DBXYD/Robotic_HolonomeRobot/hardware_3D/supportRobot.stl

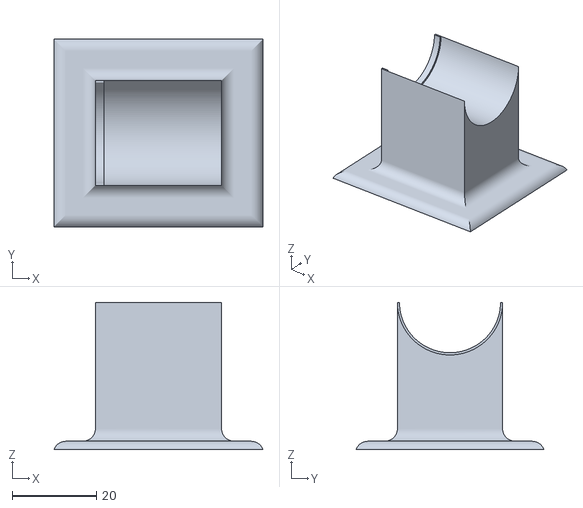
[picture p1: CAD file, 2023-02-05]
hardware_3D/supportRobot.stl
49.7 x 44.7 x 35.0
