DBXYD/Robotic_HolonomeRobot/hardware_PCB/holonomeRobot_alpha.kicad_pcb

## KiCad design hardware_PCB/holonomeRobot_alpha.kicad_pcb (2023-02-05)

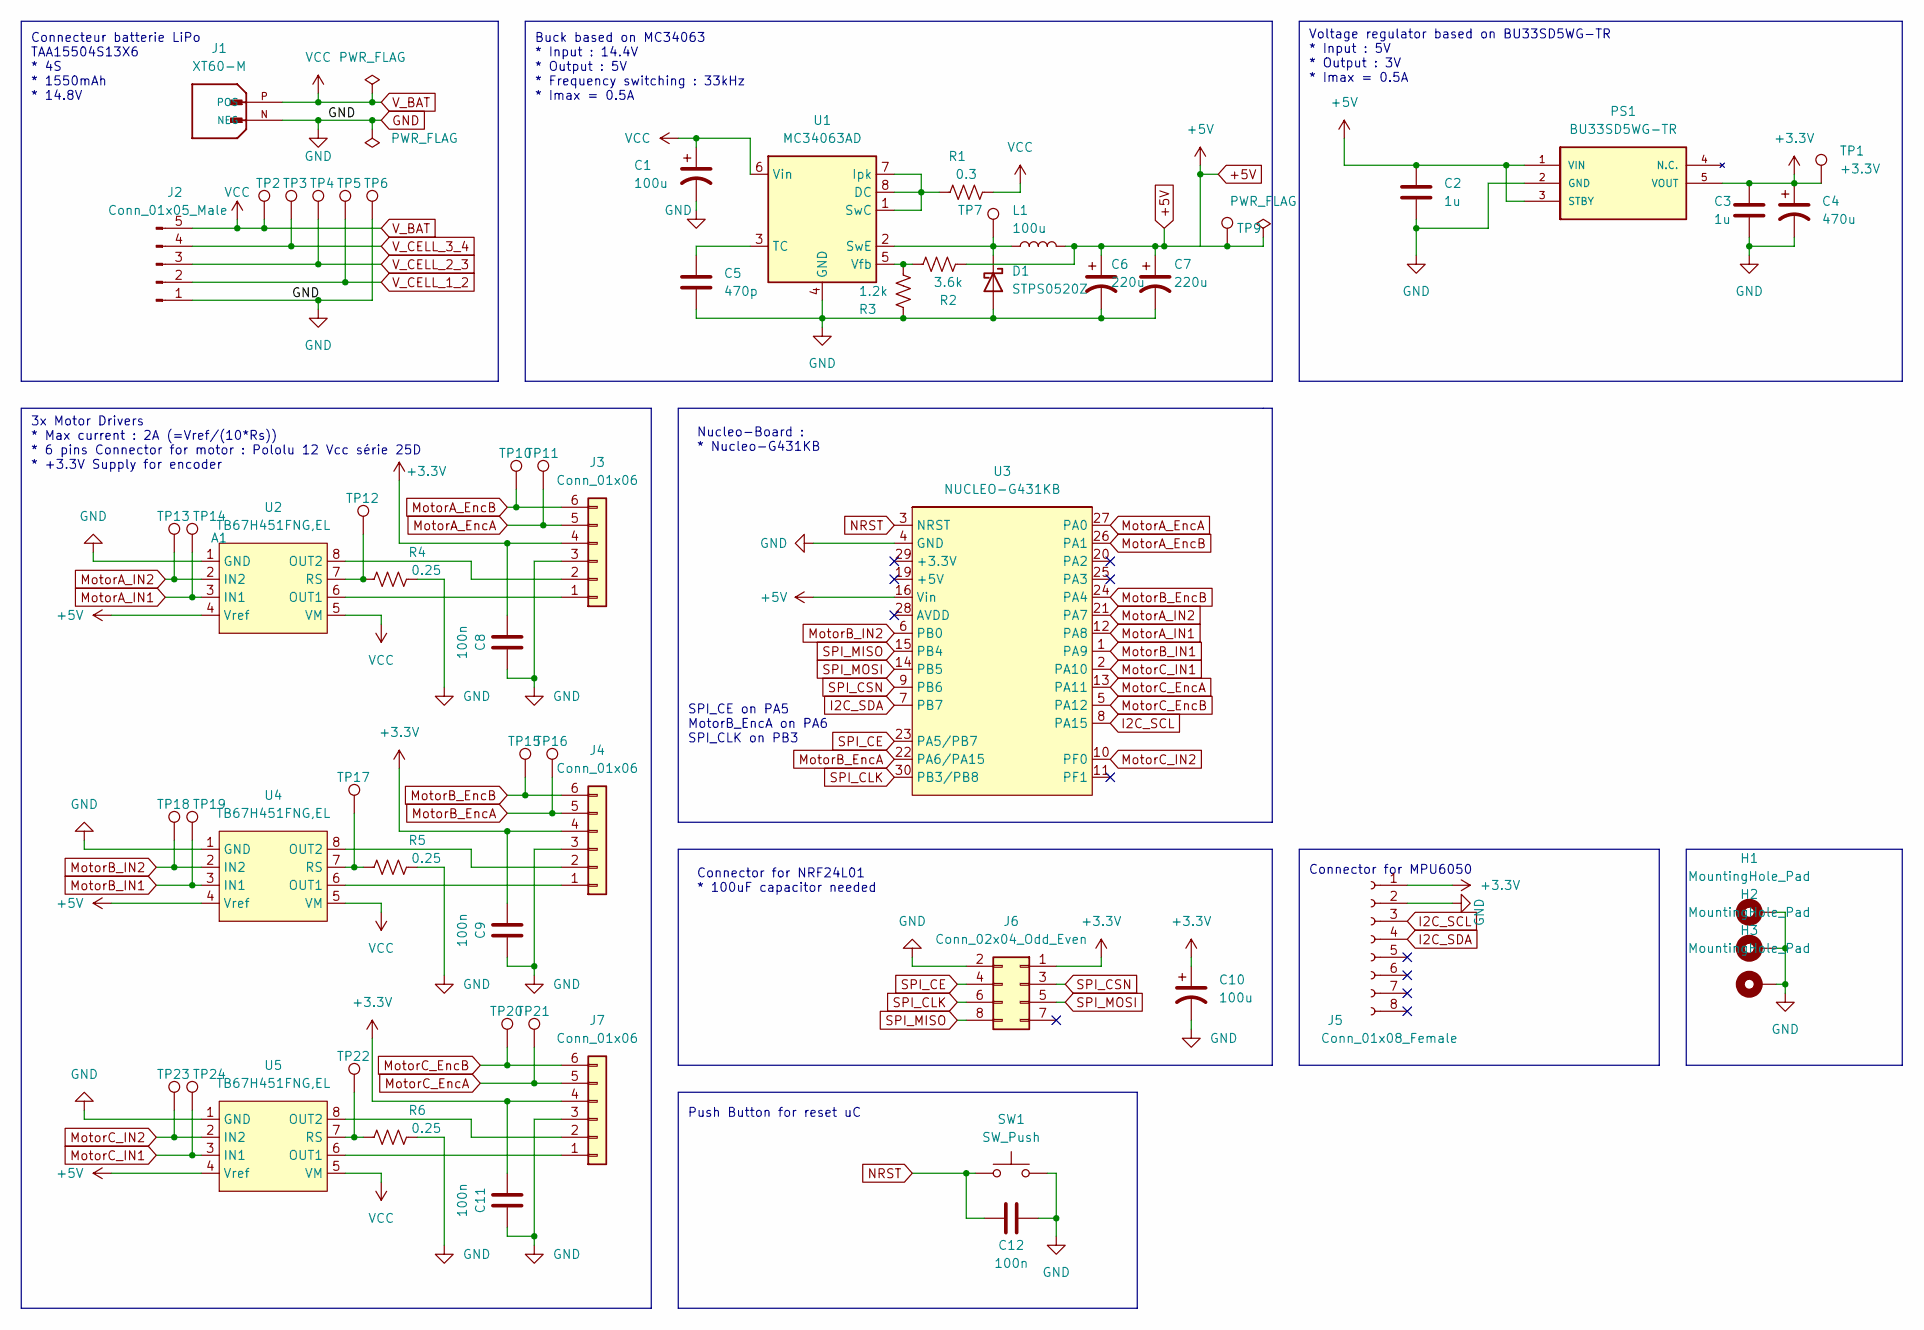
[picture p2: schematic holonomeRobot_alpha.kicad_sch, Holonome Robot]

Parts:
C1, C10: 100u; CP_Elec_6.3x7.7
C2, C3: 1u; C_0603_1608Metric_Pad1.08x0.95mm_HandSolder
C4: 470u; CP_Elec_10x10.5
C5: 470p; C_0603_1608Metric_Pad1.08x0.95mm_HandSolder
C6, C7: 220u; CP_Elec_8x10.5
C8, C9, C11, C12: 100n; C_0603_1608Metric_Pad1.08x0.95mm_HandSolder
D1: STPS0520Z; D_SOD-123
H1, H2, H3: MountingHole_Pad; MountingHole_3.2mm_M3_Pad
J1: XT60-M; AMASS_XT60-M; PARTREV V1.2
J2: Conn_01x05_Male; JST_XH_B5B-XH-A_1x05_P2.50mm_Vertical
J3, J4, J7: Conn_01x06; JST_XH_S6B-XH-A_1x06_P2.50mm_Horizontal
J5: Conn_01x08_Female; PinSocket_1x08_P2.54mm_Vertical
J6: Conn_02x04_Odd_Even; PinSocket_2x04_P2.54mm_Vertical
L1: 100u; L_12x12mm_H6mm
PS1: BU33SD5WG-TR; SOT95P280X125-5N; Manufacturer_Part_Number BU33SD5WG-TR; Mouser_Part_Number 755-BU33SD5WG-TR
R1: 0.3; R_0603_1608Metric_Pad0.98x0.95mm_HandSolder
R2: 3.6k; R_0603_1608Metric_Pad0.98x0.95mm_HandSolder
R3: 1.2k; R_0603_1608Metric_Pad0.98x0.95mm_HandSolder
R4, R5, R6: 0.25; R_0603_1608Metric_Pad0.98x0.95mm_HandSolder
SW1: SW_Push; SW_SMD_2-1437565-8_4_4.50_6.00_6.00_5.00
TP1: +3.3V; TestPoint_Pad_D1.0mm
TP2: V_BAT; TestPoint_Pad_D1.0mm
TP3: V_CELL_3_4; TestPoint_Pad_D1.0mm
TP4: V_CELL_2_3; TestPoint_Pad_D1.0mm
TP5: V_CELL_1_2; TestPoint_Pad_D1.0mm
TP6: GND_BAT; TestPoint_Pad_D1.0mm
TP7: BUCK_OUT; TestPoint_Pad_D1.0mm
TP9: +5V; TestPoint_Pad_D1.0mm
TP10: AEncB; TestPoint_Pad_D1.0mm
TP11: AEncA; TestPoint_Pad_D1.0mm
TP12: RsA; TestPoint_Pad_D1.0mm
TP13: A2; TestPoint_Pad_D1.0mm
TP14: A1; TestPoint_Pad_D1.0mm
TP15: BEncB; TestPoint_Pad_D1.0mm
TP16: BEncA; TestPoint_Pad_D1.0mm
TP17: RsB; TestPoint_Pad_D1.0mm
TP18: B2; TestPoint_Pad_D1.0mm
TP19: B1; TestPoint_Pad_D1.0mm
TP20: CEncB; TestPoint_Pad_D1.0mm
TP21: CEncA; TestPoint_Pad_D1.0mm
TP22: RsC; TestPoint_Pad_D1.0mm
TP23: C2; TestPoint_Pad_D1.0mm
TP24: C1; TestPoint_Pad_D1.0mm
U1: MC34063AD; SOIC-8_3.9x4.9mm_P1.27mm
U2, U4, U5: TB67H451FNG,EL; HSOP-8-1EP_3.9x4.9mm_P1.27mm_EP2.41x3.1mm
U3: NUCLEO-G431KB; MODULE_NUCLEO-G431KB

Connections:
+3.3V: C3.1, C4.1, C8.2, C9.2, C10.1, C11.2, J3.4, J4.4, J5.1, J6.1, J7.4, PS1.5 (VOUT), TP1.1
+5V: C2.1, C6.1, C7.1, L1.2, PS1.1 (VIN), PS1.3 (STBY), R2.2, TP9.1, U2.4 (Vref), U3.16 (Vin), U4.4 (Vref), U5.4 (Vref)
GND: C1.2, C2.2, C3.2, C4.2, C5.2, C6.2, C7.2, C8.1, C9.1, C10.2, C11.1, C12.1, D1.2 (A), H1.1, H2.1, H3.1, J1.N (NEG), J2.1, J3.3, J4.3, J5.2, J6.2, J7.3, PS1.2 (GND), R3.2, R4.2, R5.2, R6.2, SW1.2, TP6.1, U1.4 (GND), U2.1 (GND), U3.4 (GND), U4.1 (GND), U5.1 (GND)
I2C_SCL: J5.3, U3.8 (PA15)
I2C_SDA: J5.4, U3.7 (PB7)
MotorA_EncA: J3.5, TP11.1, U3.27 (PA0)
MotorA_EncB: J3.6, TP10.1, U3.26 (PA1)
MotorA_IN1: TP14.1, U2.3 (IN1), U3.12 (PA8)
MotorA_IN2: TP13.1, U2.2 (IN2), U3.21 (PA7)
MotorB_EncA: J4.5, TP16.1, U3.22 (PA6/PA15)
MotorB_EncB: J4.6, TP15.1, U3.24 (PA4)
MotorB_IN1: TP19.1, U3.1 (PA9), U4.3 (IN1)
MotorB_IN2: TP18.1, U3.6 (PB0), U4.2 (IN2)
MotorC_EncA: J7.5, TP21.1, U3.13 (PA11)
MotorC_EncB: J7.6, TP20.1, U3.5 (PA12)
MotorC_IN1: TP24.1, U3.2 (PA10), U5.3 (IN1)
MotorC_IN2: TP23.1, U3.10 (PF0), U5.2 (IN2)
NRST: C12.2, SW1.1, U3.3 (NRST)
unnamed: C5.1, U1.3 (TC)
unnamed: D1.1 (K), L1.1, TP7.1, U1.2 (SwE)
unnamed: J3.1, U2.6 (OUT1)
unnamed: J3.2, U2.8 (OUT2)
unnamed: J7.1, U5.6 (OUT1)
unnamed: J7.2, U5.8 (OUT2)
unnamed: R1.1, U1.1 (SwC), U1.7 (Ipk), U1.8 (DC)
unnamed: R2.1, R3.1, U1.5 (Vfb)
unnamed: R4.1, TP12.1, U2.7 (RS)
unnamed: R5.1, TP17.1, U4.7 (RS)
unnamed: R6.1, TP22.1, U5.7 (RS)
unnamed: J4.1, U4.6 (OUT1)
unnamed: J4.2, U4.8 (OUT2)
SPI_CE: J6.4, U3.23 (PA5/PB7)
SPI_CLK: J6.6, U3.30 (PB3/PB8)
SPI_CSN: J6.3, U3.9 (PB6)
SPI_MISO: J6.8, U3.15 (PB4)
SPI_MOSI: J6.5, U3.14 (PB5)
V_BAT: C1.1, J1.P (POS), J2.5, R1.2, TP2.1, U1.6 (Vin), U2.5 (VM), U4.5 (VM), U5.5 (VM)
V_CELL_1_2: J2.2, TP5.1
V_CELL_2_3: J2.3, TP4.1
V_CELL_3_4: J2.4, TP3.1

Notes on the sheet:
3x Motor Drivers * Max current : 2A (=Vref/(10*Rs)) * 6 pins Connector for motor : Pololu 12 Vcc série 25D * +3.3V Supply for encoder
SPI_CE on PA5 MotorB_EncA on PA6 SPI_CLK on PB3
Voltage regulator based on BU33SD5WG-TR * Input : 5V * Output : 3V * Imax = 0.5A
Connector for MPU6050
Connector for NRF24L01 * 100uF capacitor needed
Push Button for reset uC
Connecteur batterie LiPo TAA15504S13X6 * 4S * 1550mAh * 14.8V
Nucleo-Board : * Nucleo-G431KB
Buck based on MC34063 * Input : 14.4V * Output : 5V * Frequency switching : 33kHz * Imax = 0.5A

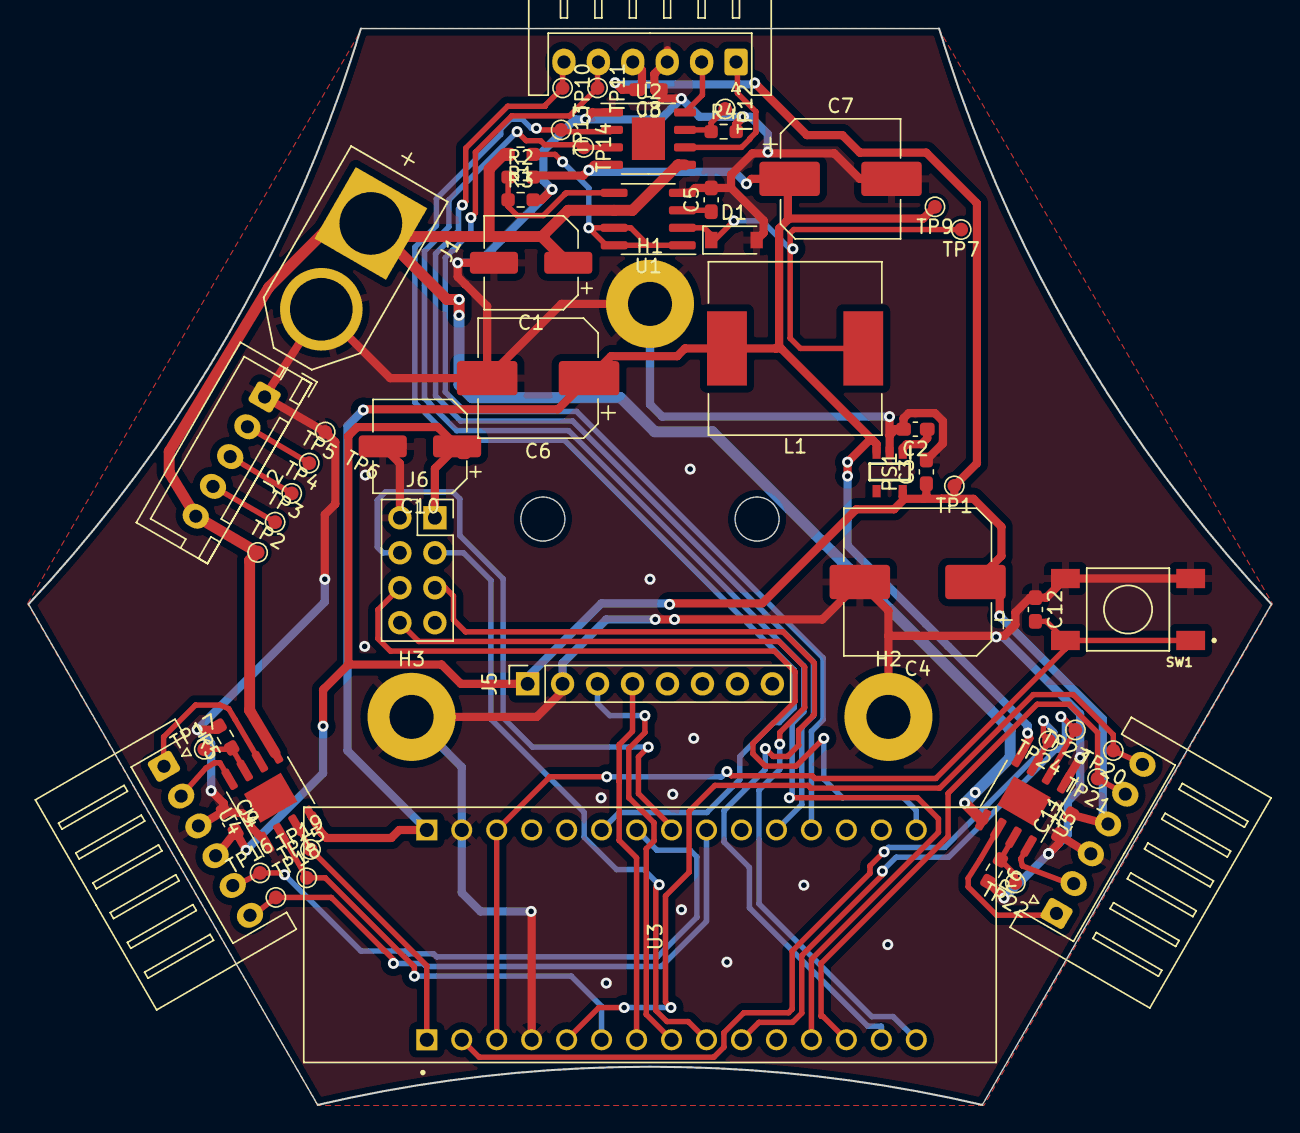
[picture p3: board holonomeRobot_alpha.kicad_pcb from above]

Board: 2 copper layers, 90.3 x 78.2 mm, 60 parts (0 on the bottom side), 40 nets.
