DBXYD/Robotic_HolonomeRobot/firmware/holonome_v1.ioc

Mcu.UserName=STM32G431KBTx
PA0.Signal=S_TIM2_CH1
PA1.Signal=S_TIM2_CH2
PA10.Signal=S_TIM1_CH3
PA11.Signal=S_TIM4_CH1
PA12.Signal=S_TIM4_CH2
PA13.GPIO_Label=T_SWDIO
PA13.Signal=SYS_JTMS-SWDIO
PA14.GPIO_Label=T_SWCLK
PA14.Signal=SYS_JTCK-SWCLK
PA15.Signal=I2C1_SCL
PA2.GPIO_Label=USART2_TX [ST-LINKV3E_VCP_RX]
PA2.Signal=USART2_TX
PA3.GPIO_Label=USART2_RX [ST-LINKV3E_VCP_TX]
PA3.Signal=USART2_RX
PA4.Signal=S_TIM3_CH2
PA5.GPIO_Label=SPI1_CE
PA5.Signal=GPIO_Output
PA6.Signal=S_TIM3_CH1
PA7.Signal=TIM1_CH1N
PA8.Signal=S_TIM1_CH1
PA9.Signal=S_TIM1_CH2
PB0.Signal=TIM1_CH2N
PB3.Signal=SPI1_SCK
PB4.Signal=SPI1_MISO
PB5.Signal=SPI1_MOSI
PB6.GPIO_Label=SPI1_CSN
PB6.Signal=GPIO_Output
PB7.Signal=I2C1_SDA
PB8-BOOT0.GPIO_Label=LED
PB8-BOOT0.Signal=GPIO_Output
PF0-OSC_IN.Signal=TIM1_CH3N
