DBXYD/Robotic_HolonomeRobot/firmware/Core/Inc/main.h

#define USART2_TX_Pin GPIO_PIN_2
#define USART2_TX_GPIO_Port GPIOA
#define USART2_RX_Pin GPIO_PIN_3
#define USART2_RX_GPIO_Port GPIOA
#define SPI1_CE_Pin GPIO_PIN_5
#define SPI1_CE_GPIO_Port GPIOA
#define T_SWDIO_Pin GPIO_PIN_13
#define T_SWDIO_GPIO_Port GPIOA
#define T_SWCLK_Pin GPIO_PIN_14
#define T_SWCLK_GPIO_Port GPIOA
#define SPI1_CSN_Pin GPIO_PIN_6
#define SPI1_CSN_GPIO_Port GPIOB
#define LED_Pin GPIO_PIN_8
#define LED_GPIO_Port GPIOB
