DBXYD/Robotic_HolonomeRobot/firmware/Core/Src/mpu6050.c

#include "mpu6050.h"



HAL_StatusTypeDef MPU6050_Init(void)
{
	uint8_t check;
	uint8_t Data;

	// check device ID WHO_AM_I

	HAL_I2C_Mem_Read(&hi2c1, MPU6050_ADDR, WHO_AM_I_REG,1, &check, 1, 1000);

	if (check == 0x68)  // 0x68 will be returned by the sensor if everything goes well
	{
		// power management register 0X6B we should write all 0's to wake the sensor up
		Data = 0;
		HAL_I2C_Mem_Write(&hi2c1, MPU6050_ADDR, PWR_MGMT_1_REG, 1,&Data, 1, 1000);

		// Set DATA RATE of 1KHz by writing SMPLRT_DIV register
		Data = 0x07;
		HAL_I2C_Mem_Write(&hi2c1, MPU6050_ADDR, SMPLRT_DIV_REG, 1, &Data, 1, 1000);

		// Set accelerometer configuration in ACCEL_CONFIG Register
		// XA_ST=0,YA_ST=0,ZA_ST=0, FS_SEL=0 -> ± 2g
		Data = 0x00;
		HAL_I2C_Mem_Write(&hi2c1, MPU6050_ADDR, ACCEL_CONFIG_REG, 1, &Data, 1, 1000);

		// Set Gyroscopic configuration in GYRO_CONFIG Register
		// XG_ST=0,YG_ST=0,ZG_ST=0, FS_SEL=0 -> ± 250 °/s
		Data = 0x00;
		HAL_I2C_Mem_Write(&hi2c1, MPU6050_ADDR, GYRO_CONFIG_REG, 1, &Data, 1, 1000);

		return HAL_OK;
	}
	else{
		return HAL_ERROR;
	}

}


HAL_StatusTypeDef MPU6050_Read_Accel(MPU_Accel_float *accel)
{
	uint8_t Rec_Data[6];
	HAL_StatusTypeDef ret;
	int16_t Accel_X_RAW = 0;
	int16_t Accel_Y_RAW = 0;
	int16_t Accel_Z_RAW = 0;
	// Read 6 BYTES of data starting from ACCEL_XOUT_H register

	ret = HAL_I2C_Mem_Read (&hi2c1, MPU6050_ADDR, ACCEL_XOUT_H_REG, 1, Rec_Data, 6, 1000);

	Accel_X_RAW = (int16_t)(Rec_Data[0] << 8 | Rec_Data [1]);
	Accel_Y_RAW = (int16_t)(Rec_Data[2] << 8 | Rec_Data [3]);
	Accel_Z_RAW = (int16_t)(Rec_Data[4] << 8 | Rec_Data [5]);

	/*** convert the RAW values into acceleration in 'g'
	     we have to divide according to the Full scale value set in FS_SEL
	     I have configured FS_SEL = 0. So I am dividing by 16384.0
	     for more details check ACCEL_CONFIG Register              ****/

	accel->x = Accel_X_RAW/16384.0;
	accel->y = Accel_Y_RAW/16384.0;
	accel->z = Accel_Z_RAW/16384.0;

	return ret;
}


HAL_StatusTypeDef MPU6050_Read_Gyro(MPU_Gyro_float *gyro)
{
	uint8_t Rec_Data[6];
	HAL_StatusTypeDef ret;
	int16_t Gyro_X_RAW = 0;
	int16_t Gyro_Y_RAW = 0;
	int16_t Gyro_Z_RAW = 0;

	// Read 6 BYTES of data starting from GYRO_XOUT_H register

	ret = HAL_I2C_Mem_Read (&hi2c1, MPU6050_ADDR, GYRO_XOUT_H_REG, 1, Rec_Data, 6, 1000);

	Gyro_X_RAW = (int16_t)(Rec_Data[0] << 8 | Rec_Data [1]);
	Gyro_Y_RAW = (int16_t)(Rec_Data[2] << 8 | Rec_Data [3]);
	Gyro_Z_RAW = (int16_t)(Rec_Data[4] << 8 | Rec_Data [5]);

	/*** convert the RAW values into dps (°/s)
	     we have to divide according to the Full scale value set in FS_SEL
	     I have configured FS_SEL = 0. So I am dividing by 131.0
	     for more details check GYRO_CONFIG Register              ****/

	gyro->x = Gyro_X_RAW/131.0;
	gyro->y = Gyro_Y_RAW/131.0;
	gyro->z = Gyro_Z_RAW/131.0;

	return ret;
}
